upatras-lar/ecedk905-2026/(commit log)

2026-10-22 small fixes in the tools files of lab1
    [pendulum_ringdown_fit.py, torque_fit.py, velocity_fit.py]
2026-10-22 small final fixes for lab1
    [AS5600_read.ino, find_pole_pairs_number.ino, loadcell_calib_read.ino, motor_AS5600.ino, pendulum_ringdown.ino, torque_calibration.ino, velocity_calibration.ino, velocity_fit.py]
